fitranurmayadi/twsbr/docs/results/tuning-logs/line_following_2024-09-10_11-21-43.png

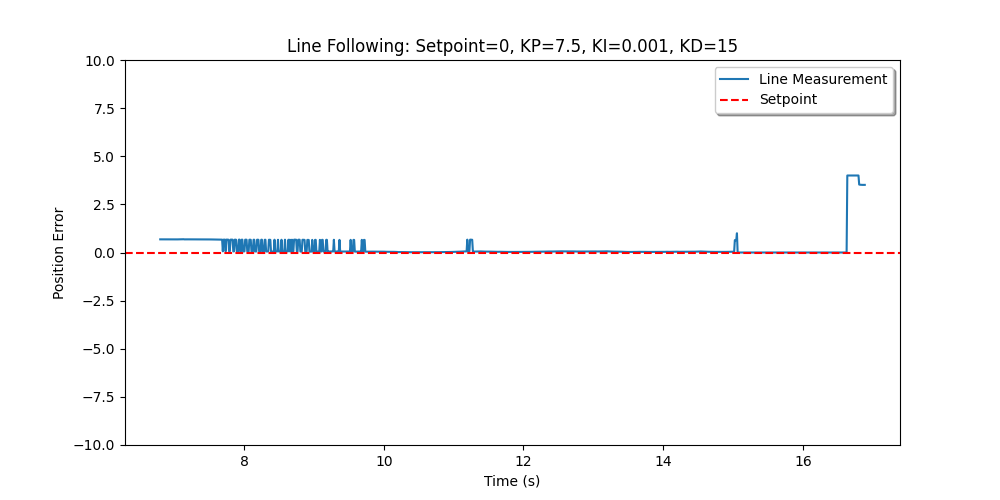
docs/results/tuning-logs/line_following_2024-09-10_11-21-43.png
