fitranurmayadi/twsbr/docs/results/tuning-logs/line_following_2024-09-10_11-28-55.png

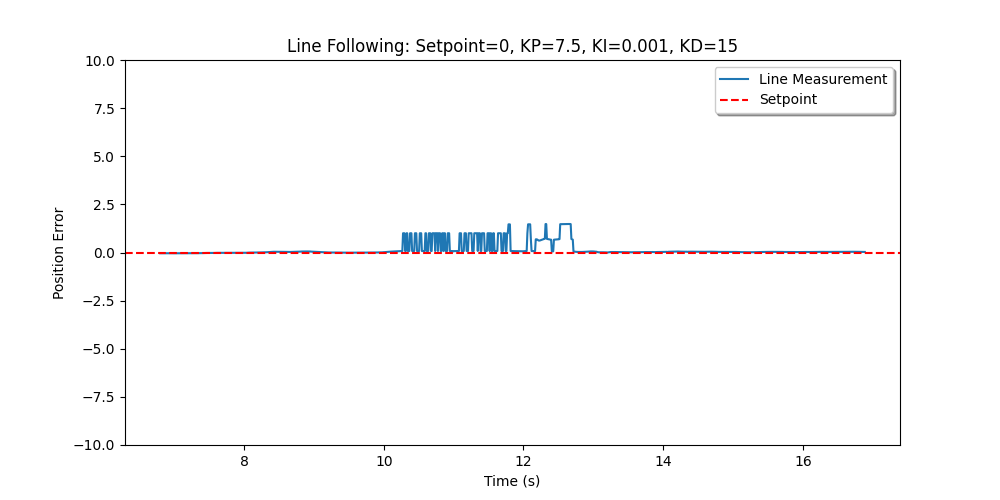
docs/results/tuning-logs/line_following_2024-09-10_11-28-55.png
