fitranurmayadi/twsbr/docs/results/tuning-logs/line_following_2024-09-10_15-40-31.png

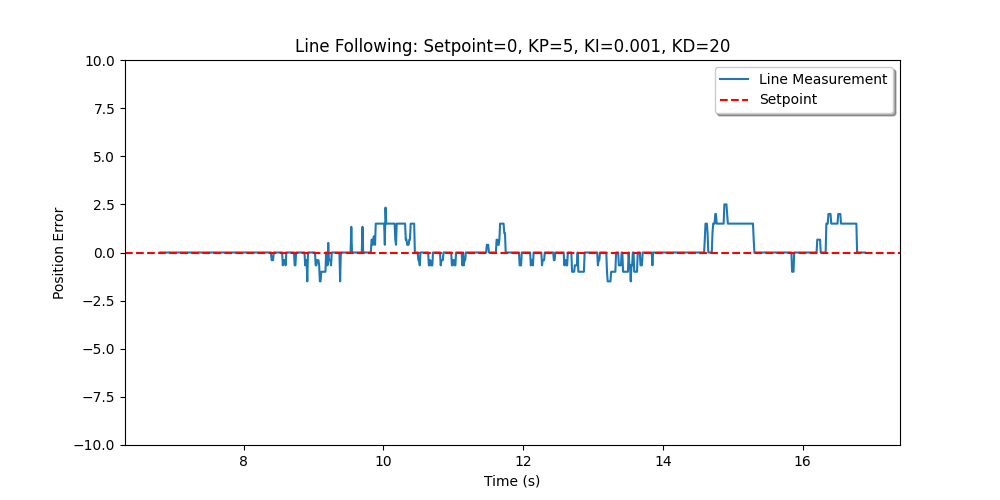
docs/results/tuning-logs/line_following_2024-09-10_15-40-31.png
