fitranurmayadi/twsbr/docs/results/tuning-logs/line_following_2024-09-10_15-45-26.png

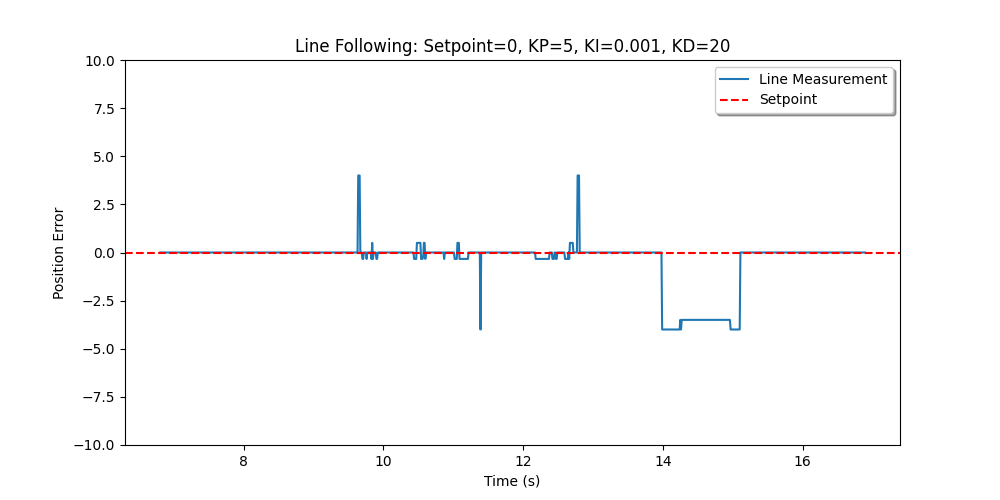
docs/results/tuning-logs/line_following_2024-09-10_15-45-26.png
