fitranurmayadi/twsbr/docs/results/tuning-logs/self_balancing_2024-09-10_15-43-12.png

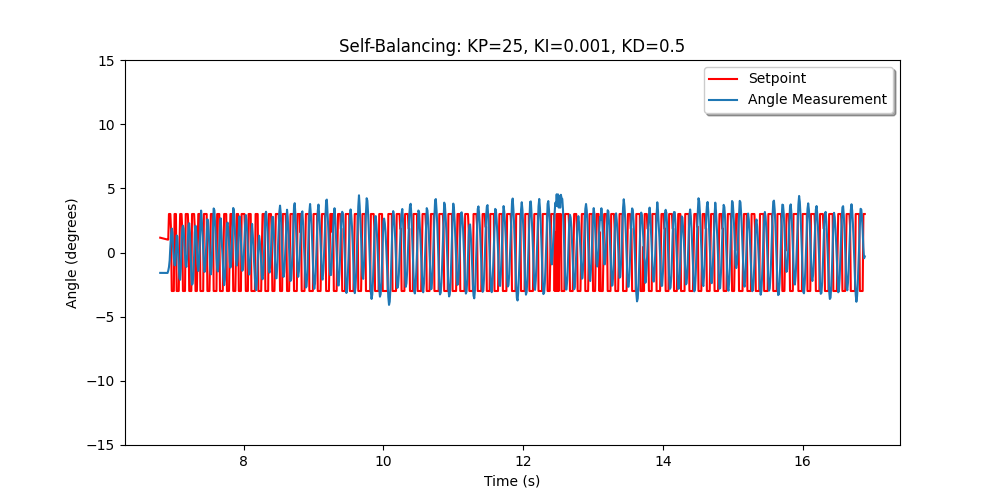
docs/results/tuning-logs/self_balancing_2024-09-10_15-43-12.png
