fitranurmayadi/twsbr/docs/results/tuning-logs/speed_2024-09-10_11-28-27.png

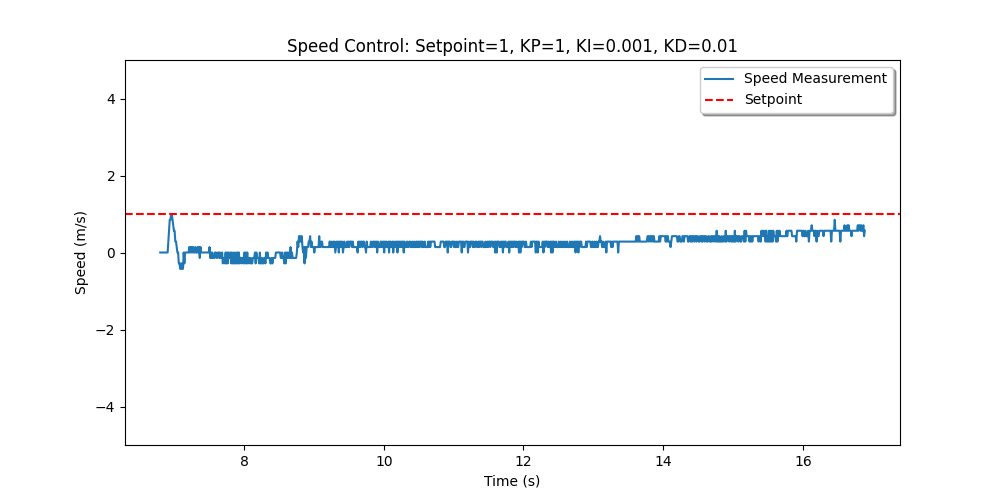
docs/results/tuning-logs/speed_2024-09-10_11-28-27.png
