fitranurmayadi/twsbr/docs/results/tuning-logs/speed_2024-09-10_15-30-02.png

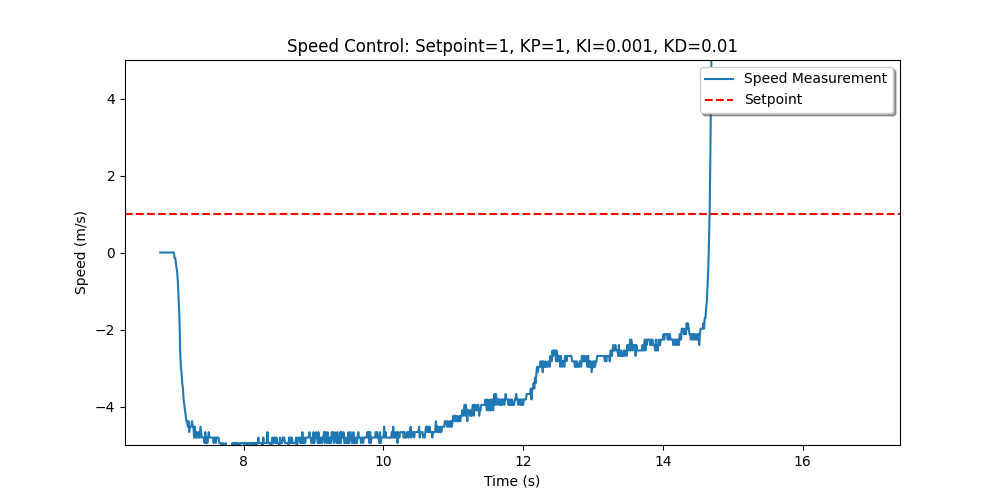
docs/results/tuning-logs/speed_2024-09-10_15-30-02.png
