fitranurmayadi/twsbr/docs/results/tuning-logs/speed_2024-09-10_15-40-31.png

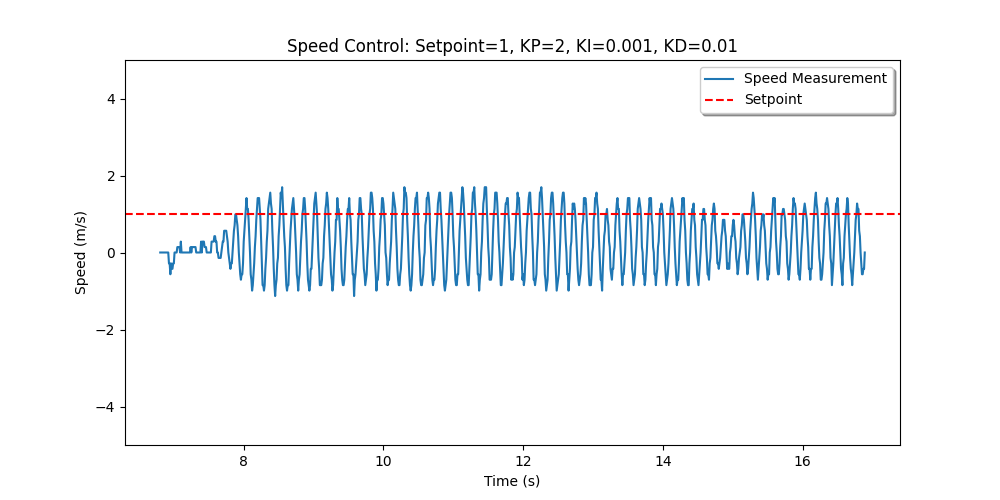
docs/results/tuning-logs/speed_2024-09-10_15-40-31.png
