fitranurmayadi/twsbr/docs/results/tuning-logs/speed_2024-09-13_11-25-10.png

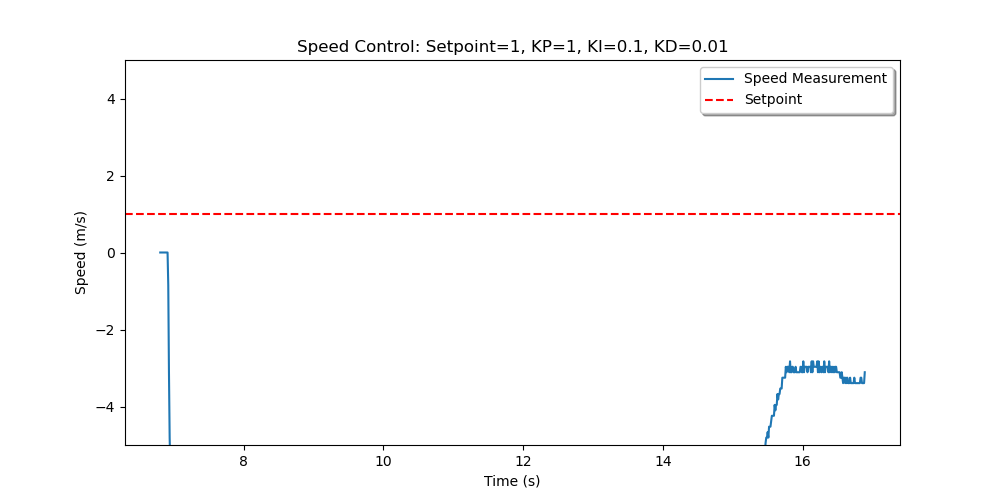
docs/results/tuning-logs/speed_2024-09-13_11-25-10.png
