fitranurmayadi/twsbr/(list of files, drawings)

Other design files:
docs/diagrams/wiring.fzz
