fitranurmayadi/twsbr/firmware/twsbr_v2_tuning_telemetry/secrets.example.h

// Template for secrets.h - copy this file to secrets.h and edit it.
// secrets.h is listed in .gitignore so your credentials stay local.
#pragma once

const char* ssid = "YOUR_WIFI_SSID";
const char* password = "YOUR_WIFI_PASSWORD";

// Address of the PC running server/app.py (same network as the robot).
const char* serverName = "http://192.168.1.100:5000/data";
