fitranurmayadi/twsbr/(commit log)

2026-11-04 Publish TWSBR: self-balancing line-following robot (ESP32-S3, cascade PID)
    Personal project (2024), cleaned up for release:
    - firmware v0-v3 as Arduino sketches, comments in English, Wi-Fi
    credentials moved to a git-ignored secrets.h
    - Flask telemetry server with CSV export and a synthetic test payload
    - project plan (Bahasa Indonesia), reference list, diagrams and tuning logs
    [wiring.fzz]
2026-11-04 Add demo video to README
    Link the September 2024 test run on the oval track and update the
    line-following status to match what the video shows.
2026-11-04 README: line following works on the oval track
    The demo shows the robot staying on the line with the usual PID weave;
    the earlier wording undersold it.
2026-11-04 Redraw control diagram as light/dark SVG
    The old PNG had a transparent background with black lines, so it was
    nearly invisible in GitHub's dark theme. The new diagram is generated
    by docs/diagrams/make_control_diagram.py, follows the v3 firmware
    (speed PID output is the angle setpoint), colour-codes each loop and
    switches with the GitHub theme via <picture>. The flowchart gets a
    white background for the same reason.
